MateEke/opentherm-thermostat/README.md

# opentherm-thermostat

Project for esp32 based opentherm thermostat
