MateEke/opentherm-thermostat/KiCad/opentherm-thermostat.stl

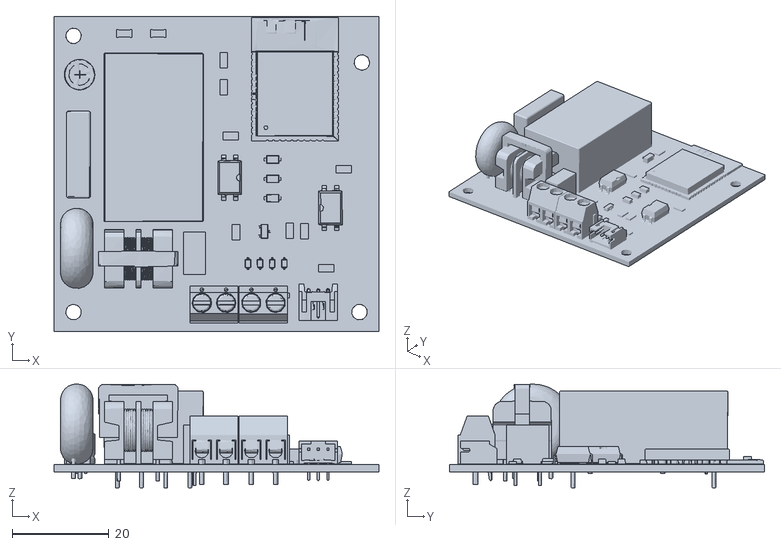
[picture p1: CAD file, 2024-12-14]
KiCad/opentherm-thermostat.stl
67.0 x 65.0 x 21.4
