MateEke/opentherm-thermostat/OpenSCAD/opentherm-thermostat.3mf

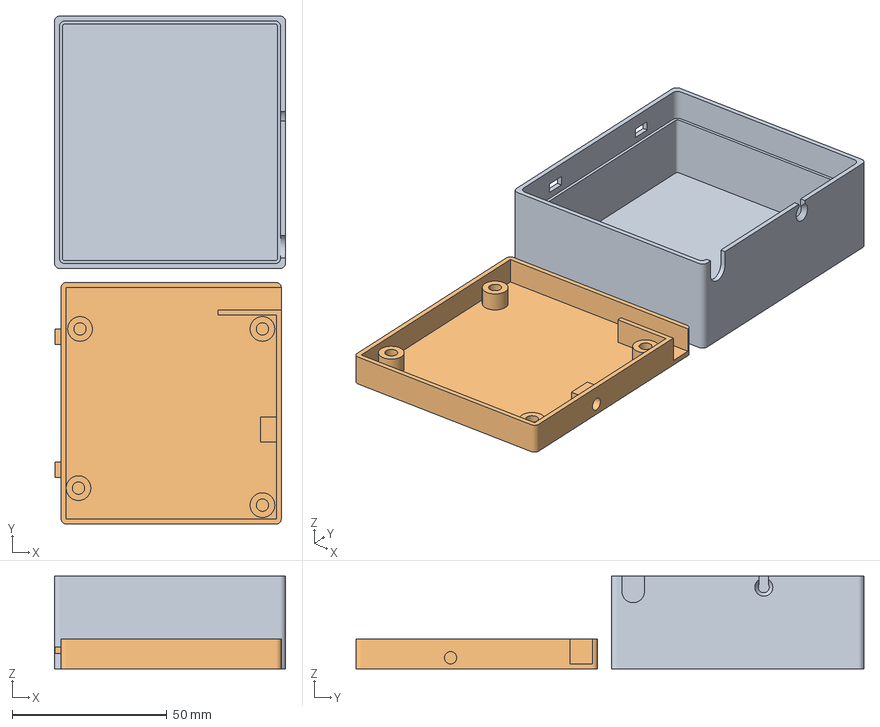
[picture p2: CAD file, 2024-12-18]
OpenSCAD/opentherm-thermostat.3mf
74.8 x 164.3 x 30.0 mm
lid.stl
base.stl
