MateEke/opentherm-thermostat/KiCad/opentherm-thermostat.kicad_pcb

## KiCad design KiCad/opentherm-thermostat.kicad_pcb (2024-12-13)

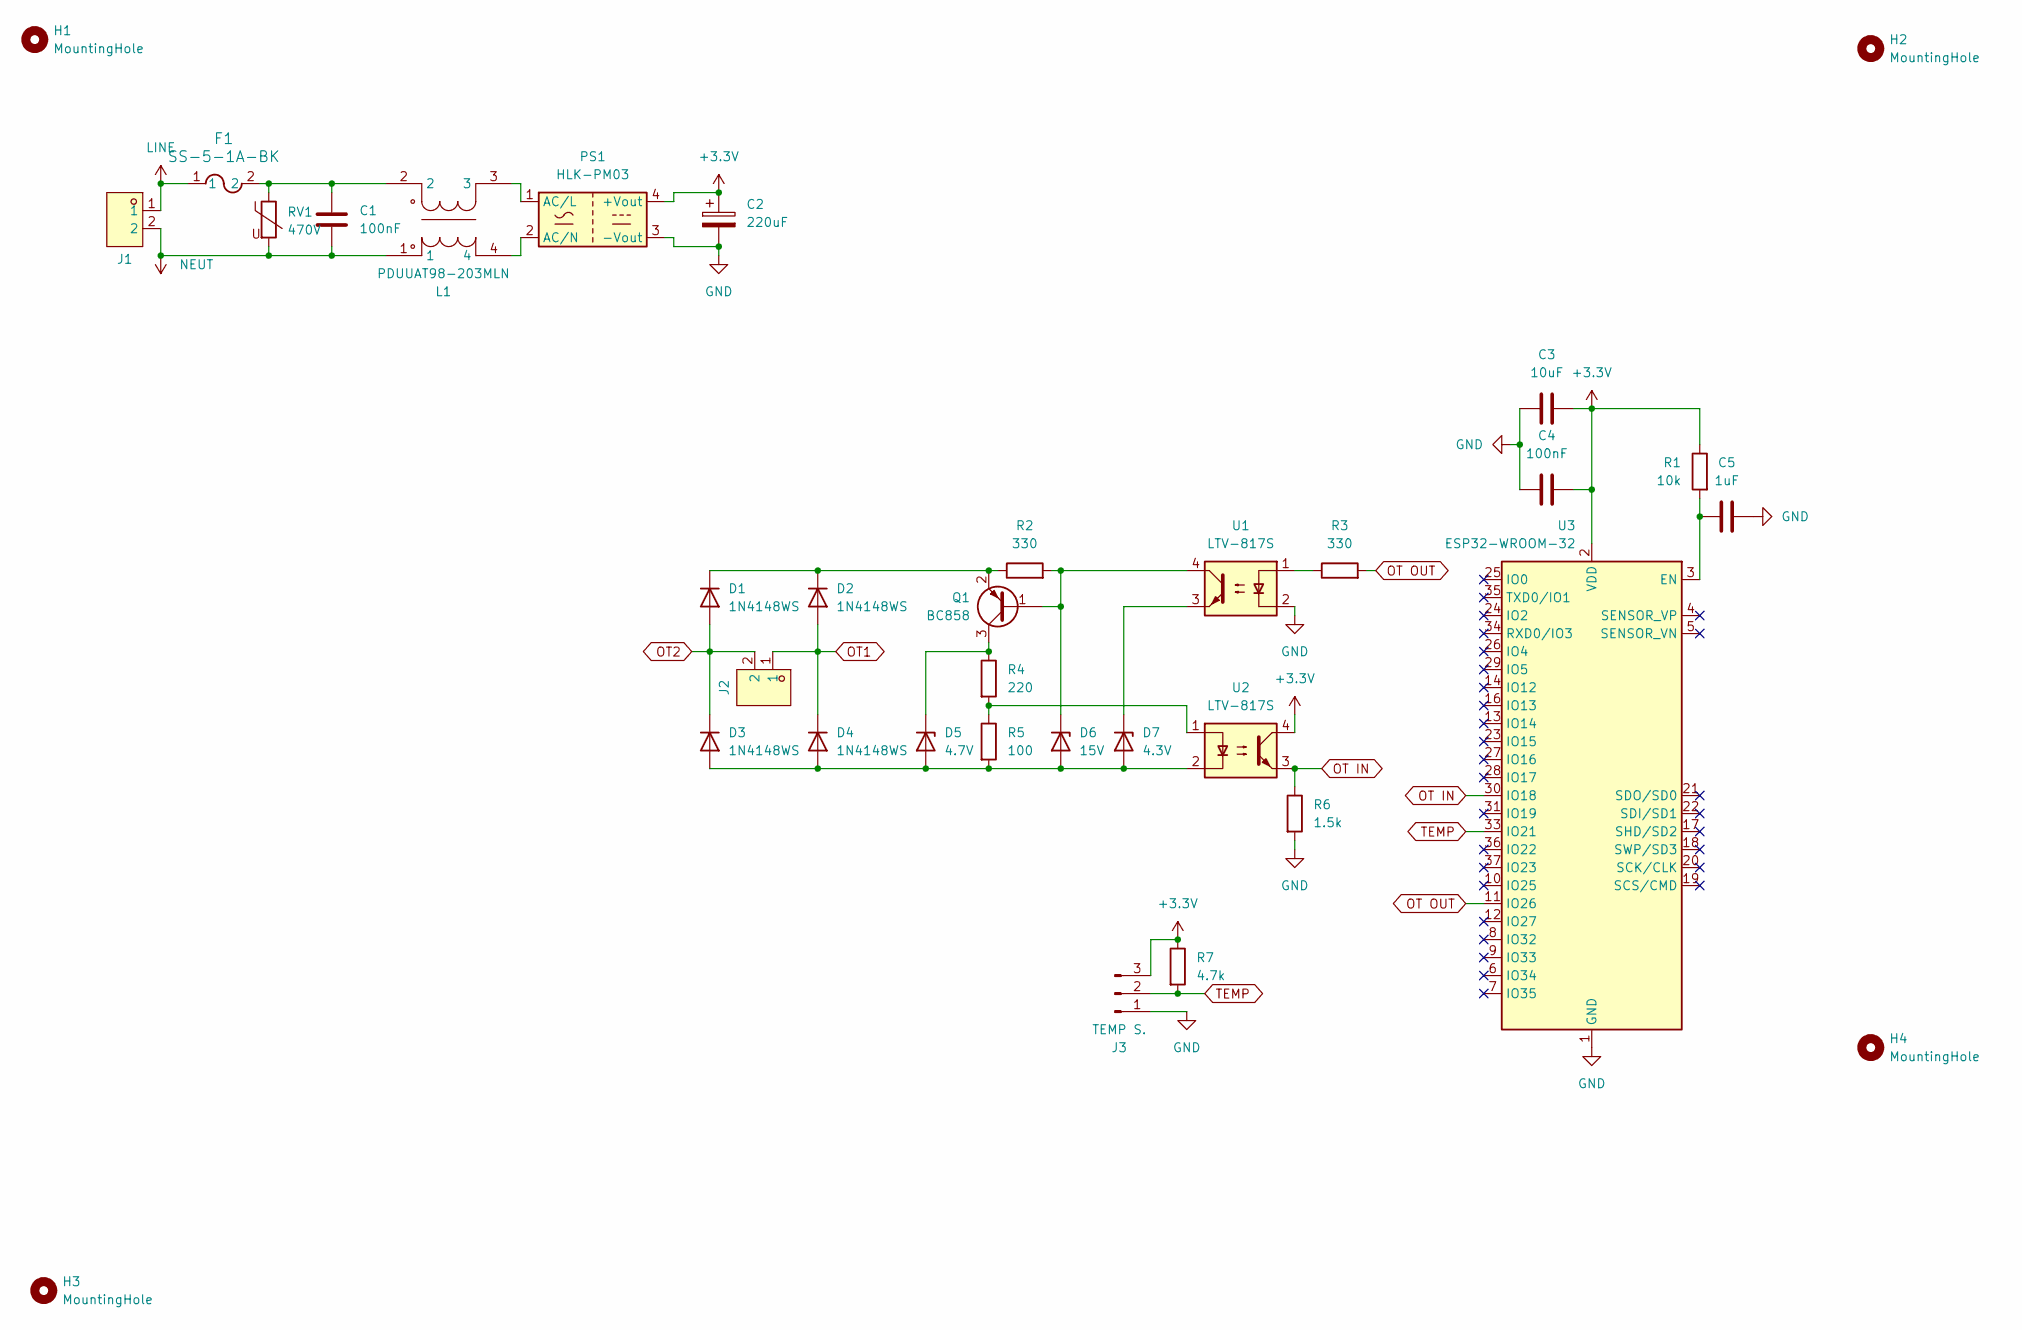
[picture p3: schematic opentherm-thermostat.kicad_sch]

Parts:
C1: 100nF; C_Rect_L18.0mm_W5.0mm_P15.00mm_FKS3_FKP3
C2: 220uF; CP_Radial_D6.3mm_P2.50mm
C3: 10uF; C_1206_3216Metric_Pad1.33x1.80mm_HandSolder
C4: 100nF; C_1206_3216Metric_Pad1.33x1.80mm_HandSolder
C5: 1uF; C_1206_3216Metric_Pad1.33x1.80mm_HandSolder
D1, D2, D3, D4: 1N4148WS; D_SOD-323_HandSoldering
D5: 4.7V; D_SOD-123F
D6: 15V; D_SOD-123F
D7: 4.3V; D_SOD-123F
F1: SS-5-1A-BK; FUS_CB_SS-5
H1, H2, H3, H4: MountingHole; MountingHole_3.2mm_M3_DIN965
J1, J2: KF301-5.0-2P; CONN-TH_P5.00_KF301-5.0-2P; LCSC Part C474881
J3: TEMP S.; JST_PH_S3B-PH-K_1x03_P2.00mm_Horizontal
L1: PDUUAT98-203MLN; FILTER-TH_4P-L17.0-W12.0-P7.00-D0.6-S8.00-1; LCSC Part C2923574
PS1: HLK-PM03; Converter_ACDC_Hi-Link_HLK-PMxx
Q1: BC858; SOT-23_Handsoldering
R1: 10k; R_1206_3216Metric_Pad1.30x1.75mm_HandSolder
R2, R3: 330; R_1206_3216Metric_Pad1.30x1.75mm_HandSolder
R4: 220; R_1206_3216Metric_Pad1.30x1.75mm_HandSolder
R5: 100; R_1206_3216Metric_Pad1.30x1.75mm_HandSolder
R6: 1.5k; R_1206_3216Metric_Pad1.30x1.75mm_HandSolder
R7: 4.7k; R_1206_3216Metric_Pad1.30x1.75mm_HandSolder
RV1: 470V; RV_Disc_D16.5mm_W6.7mm_P7.5mm
U1, U2: LTV-817S; SMDIP-4_W9.53mm
U3: ESP32-WROOM-32

Connections:
+3.3V: C2.1, C3.1, C4.1, J3.3, PS1.4 (+Vout), R1.1, R7.1, U2.4, U3.2 (VDD)
GND: C2.2, C3.2, C4.2, C5.1, J3.1, PS1.3 (-Vout), R6.2, U1.2, U3.1 (GND), U3.15 (GND), U3.38 (GND), U3.39 (GND)
LINE: F1.1, J1.1
NEUT: C1.2, J1.2, L1.1, RV1.2
unnamed: C1.1, F1.2, L1.2, RV1.1
unnamed: D1.1 (K), D2.1 (K), Q1.2 (E), R2.1
unnamed: D3.2 (A), D4.2 (A), D5.2 (A), D6.2 (A), D7.2 (A), R5.2, U2.2
unnamed: D5.1 (K), Q1.3 (C), R4.1
unnamed: D6.1 (K), Q1.1 (B), R2.2, U1.4
unnamed: D7.1 (K), U1.3
unnamed: L1.3, PS1.1 (AC/L)
unnamed: L1.4, PS1.2 (AC/N)
unnamed: R3.1, U1.1
unnamed: R4.2, R5.1, U2.1
unnamed: C5.2, R1.2, U3.3 (EN)
OT1: D2.2 (A), D4.1 (K), J2.1
OT2: D1.2 (A), D3.1 (K), J2.2
OT IN: R6.1, U2.3, U3.30 (IO18)
OT OUT: R3.2, U3.11 (IO26)
TEMP: J3.2, R7.2, U3.33 (IO21)

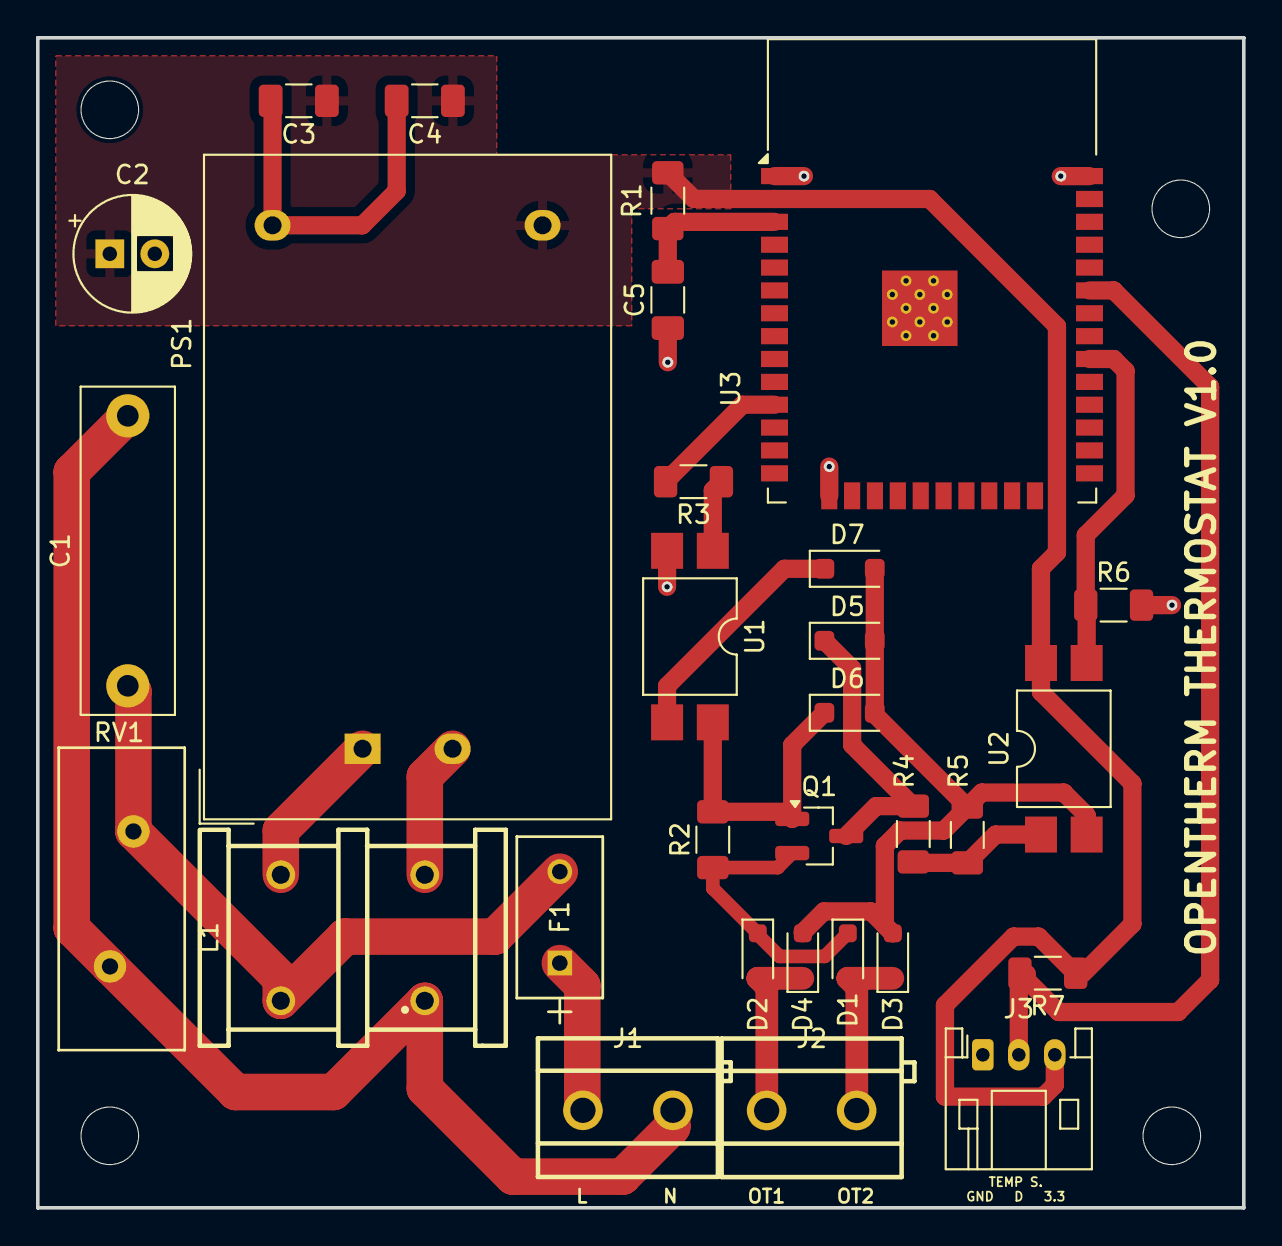
[picture p4: board opentherm-thermostat.kicad_pcb from above]

Board: 2 copper layers, 67.0 x 65.0 mm, 34 parts (0 on the bottom side), 20 nets.
