MateEke/opentherm-thermostat/(commit log)

2024-12-13 initial pcb design
    [opentherm-thermostat.kicad_pcb, opentherm-thermostat.kicad_sch]
2024-12-13 add kicad library as submodule
2024-12-14 init openscad model
    [base.scad, opentherm-thermostat.stl]
2024-12-15 first version of the case
    [base.scad, lid.scad, shared.scad]
2024-12-18 v1 finished
    [opentherm-thermostat.3mf]
2024-12-18 simplify scad
    [base.scad, lid.scad]
